grant-Gan/ECM_XLR_microphone/3D_Models/咪头支架_30mm.stl

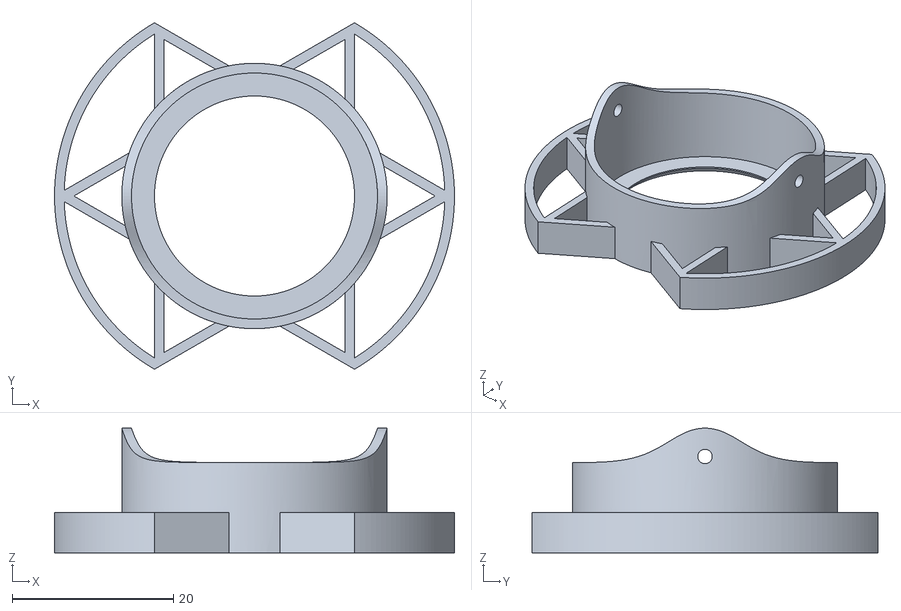
[picture p2: CAD file, 2025-09-05]
3D_Models/咪头支架_30mm.stl
49.6 x 43.0 x 15.5
