grant-Gan/ECM_XLR_microphone/3D_Models/下盖.stl

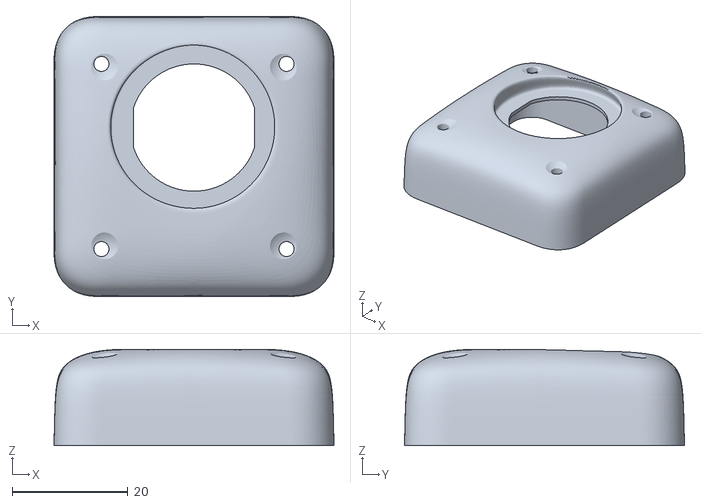
[picture p3: CAD file, 2025-09-05]
3D_Models/下盖.stl
48.4 x 48.4 x 16.6
