grant-Gan/ECM_XLR_microphone/3D_Models/咪头外壳.stl

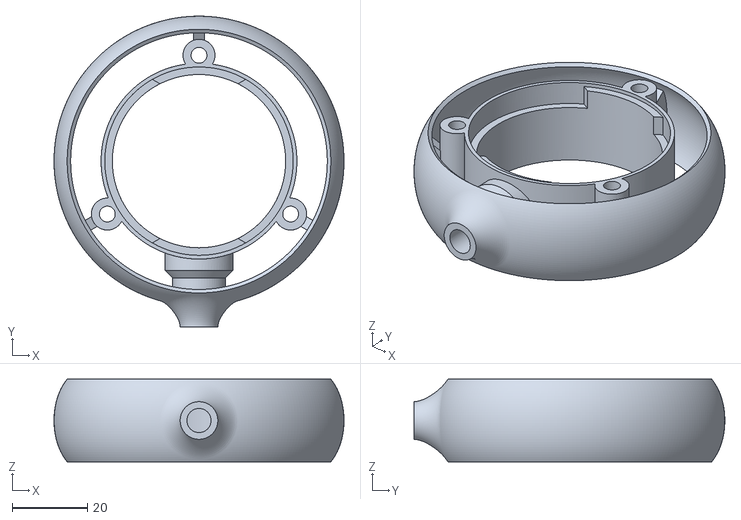
[picture p4: CAD file, 2025-09-05]
3D_Models/咪头外壳.stl
77.0 x 82.5 x 22.0
