grant-Gan/ECM_XLR_microphone/3D_Models/上盖.stl

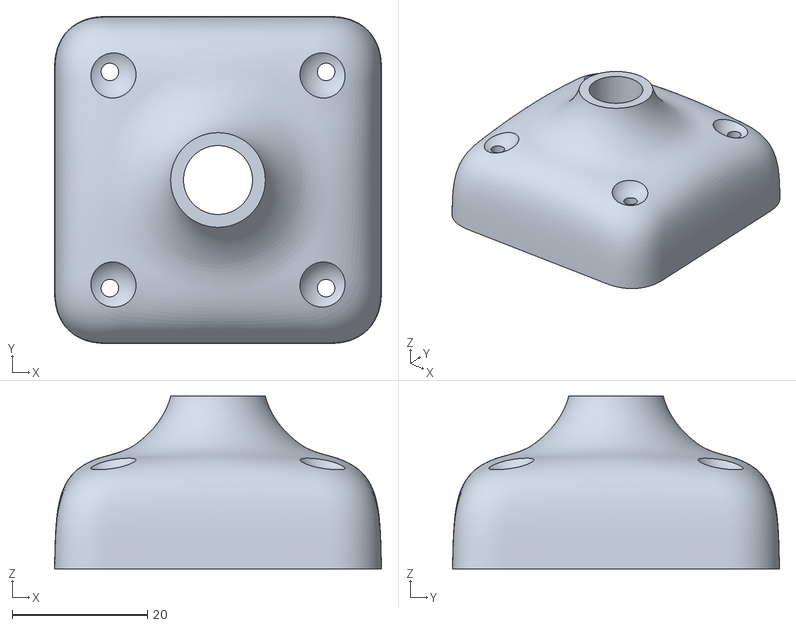
[picture p5: CAD file, 2025-09-05]
3D_Models/上盖.stl
48.4 x 48.4 x 25.6
