grant-Gan/ECM_XLR_microphone/PCB/Schematics/OPA_Alice_ECM_Microphone.pdf

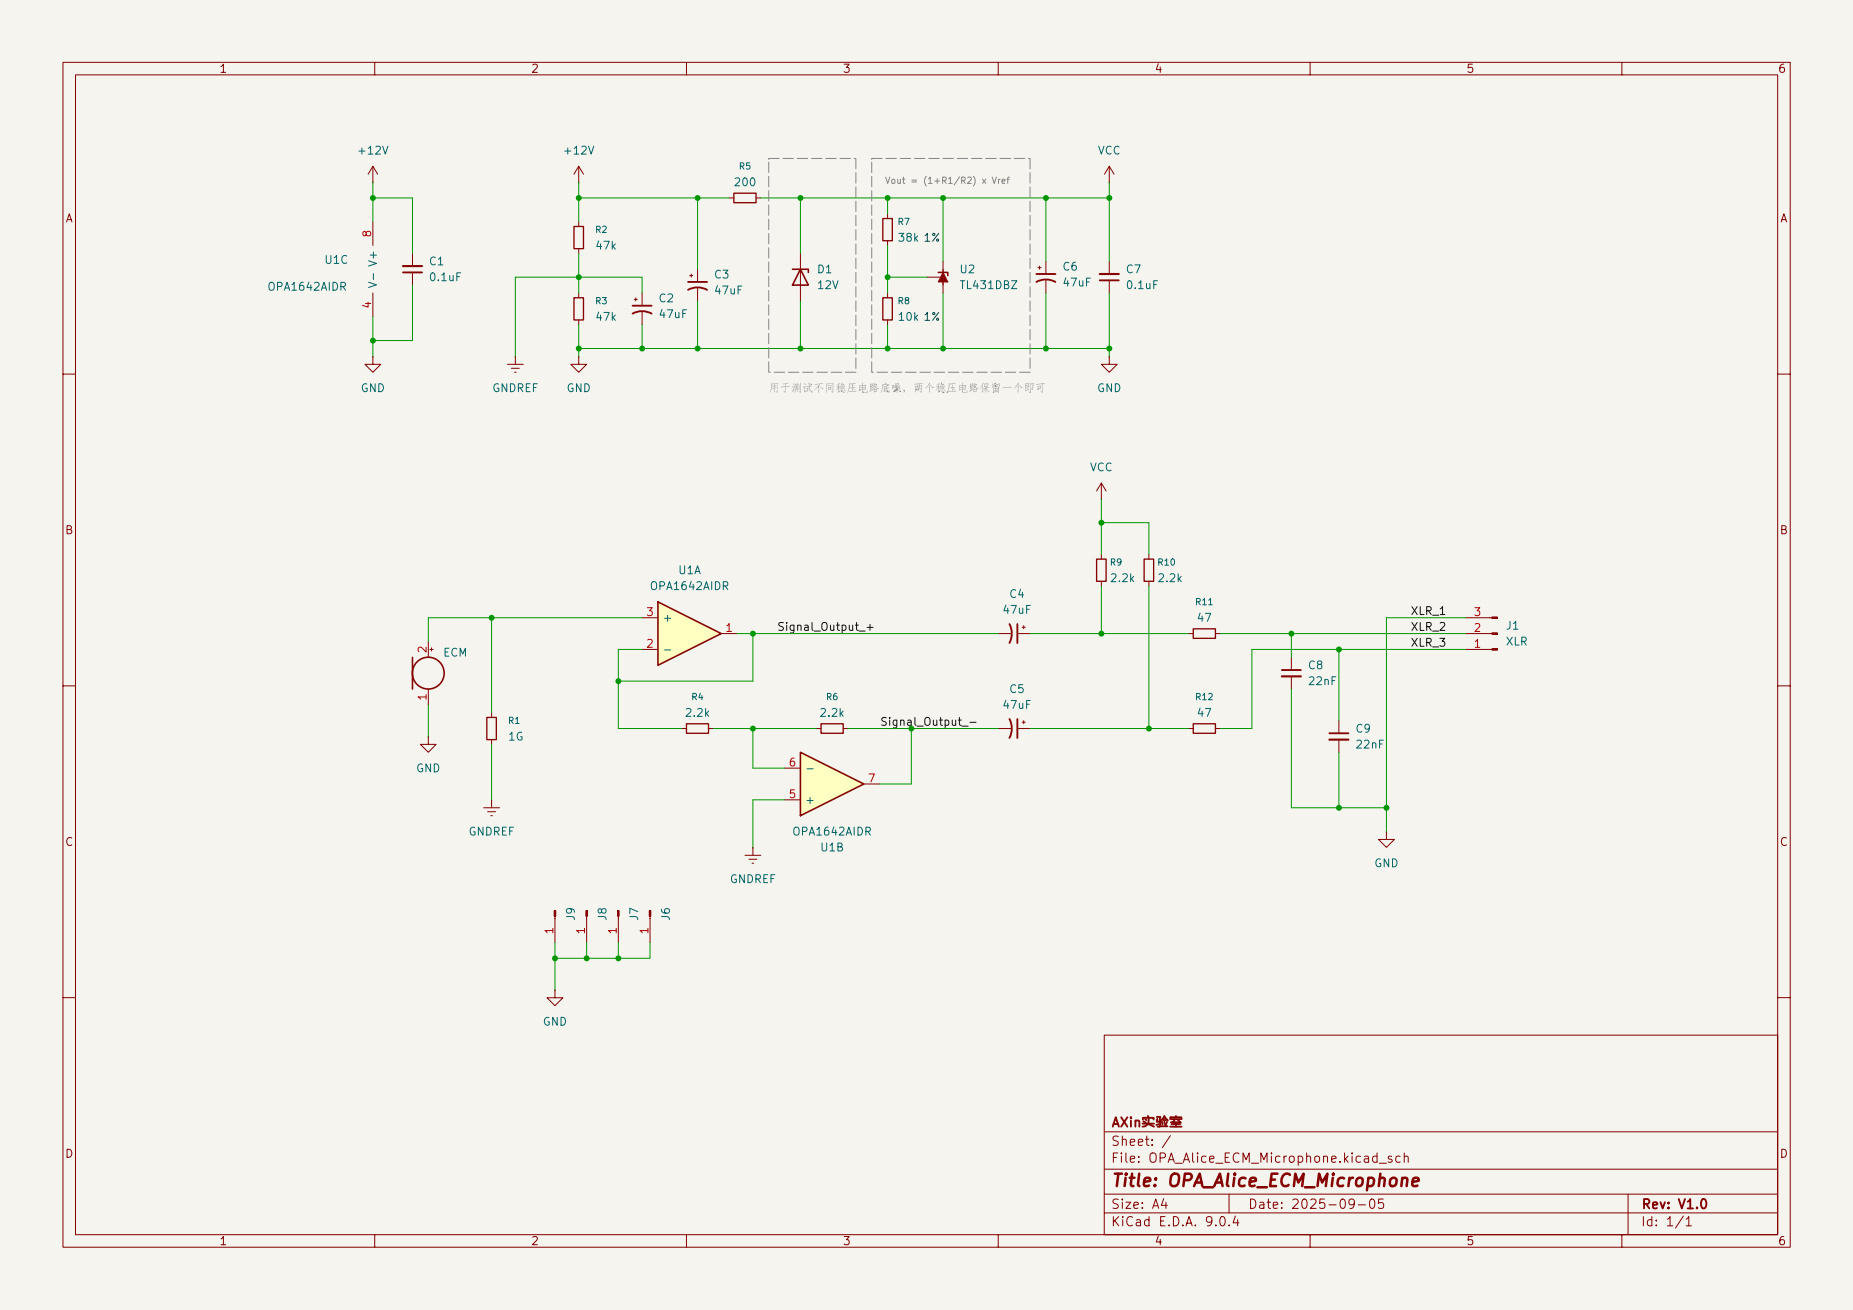
[picture p6: page 1]
