grant-Gan/ECM_XLR_microphone/PCB/PCB/OPA_Alice_ECM_Microphone_PCB.pdf

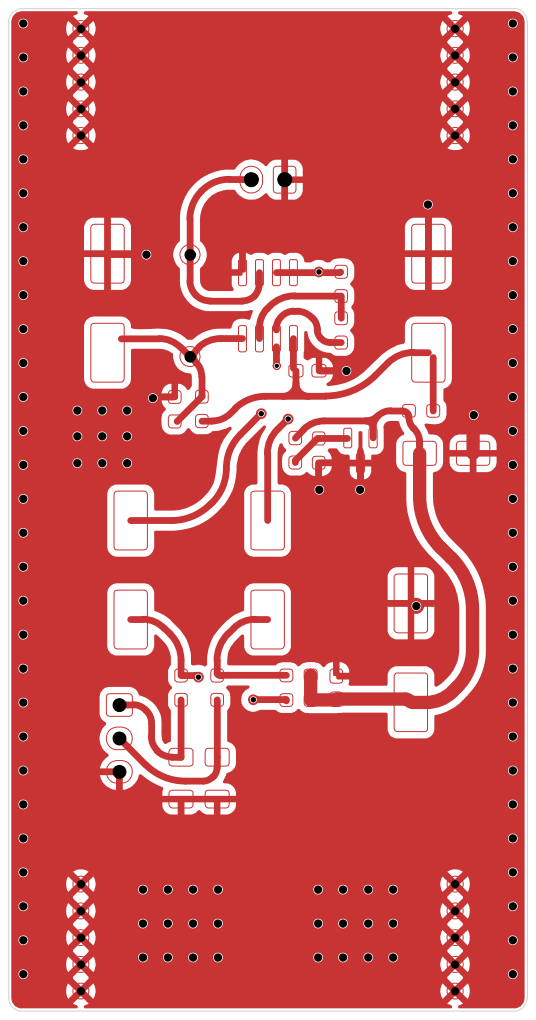
[picture p7: page 1]

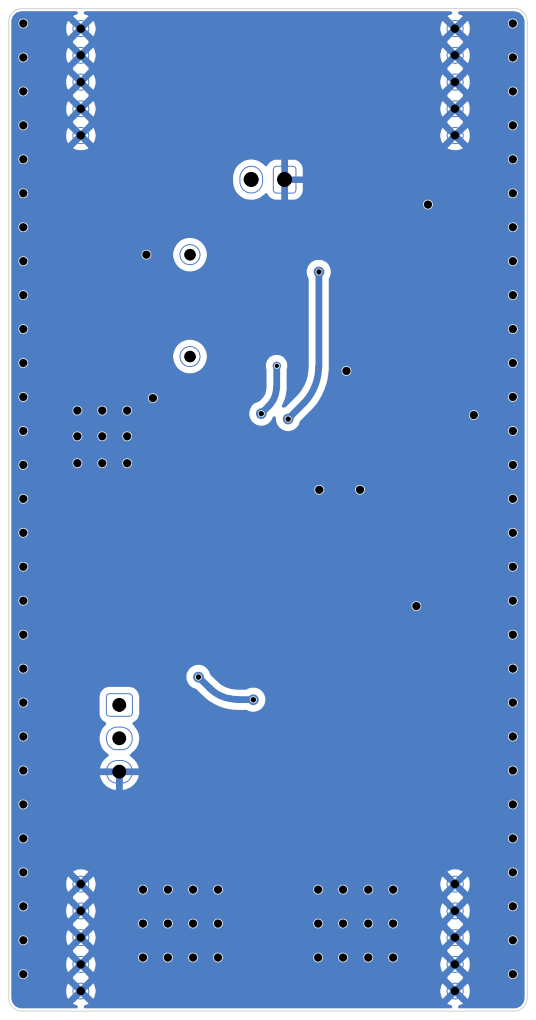
[picture p8: page 2]

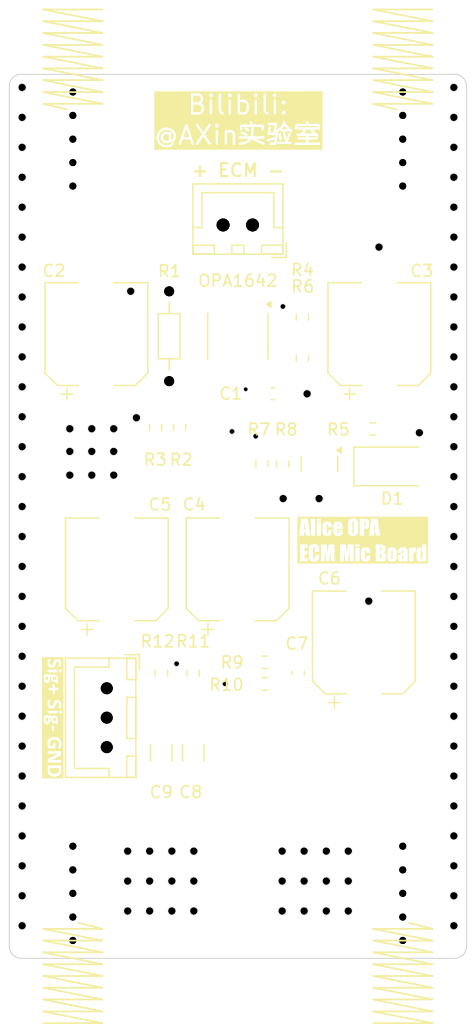
[picture p9: page 3]

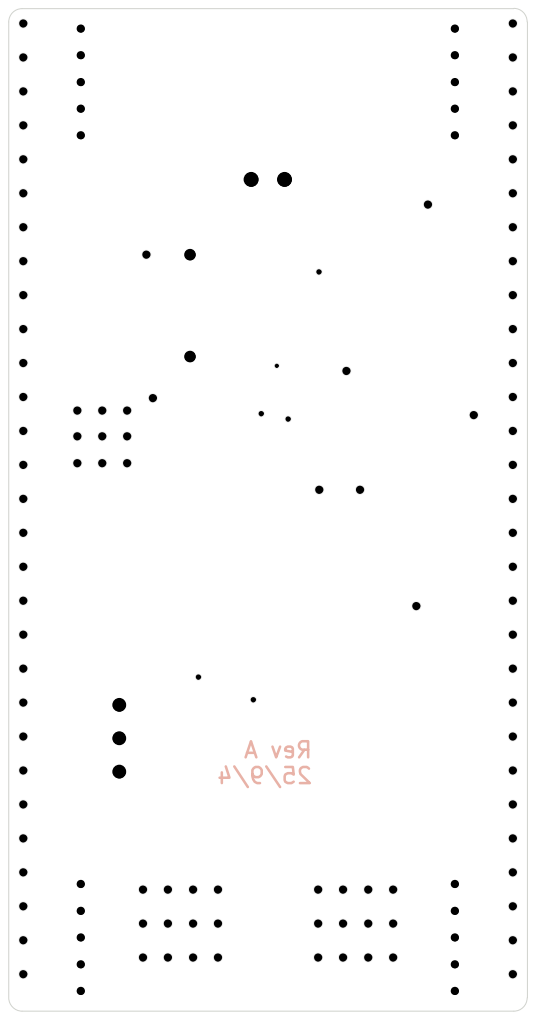
[picture p10: page 4]
