grant-Gan/ECM_XLR_microphone/PCB/Kicad_project/Alice_OPA_ECM_Microphone.kicad_pcb

## KiCad design PCB/Kicad_project/Alice_OPA_ECM_Microphone.kicad_pcb (2025-09-05)

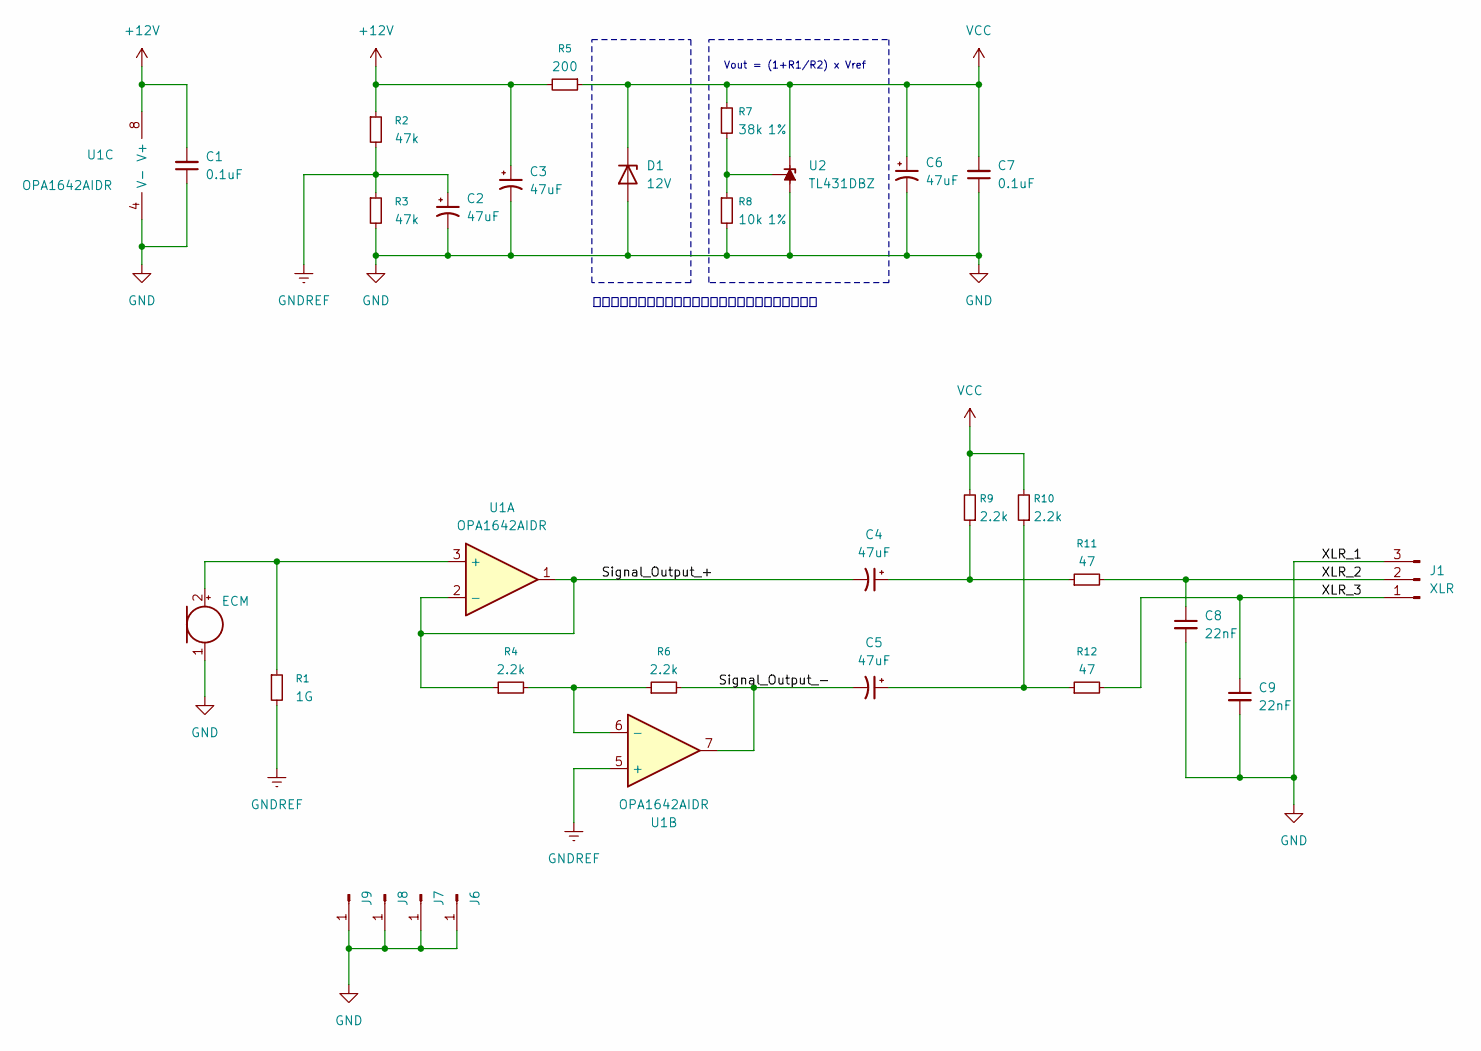
[picture p11: schematic Alice_OPA_ECM_Microphone.kicad_sch, OPA_Alice_ECM_Microphone]

Parts:
C1, C7: 0.1uF; C_0603_1608Metric_Pad1.08x0.95mm_HandSolder
C2, C3, C4, C5, C6: 47uF; CP_Elec_8x10.5; Voltage 63V
C8, C9: 22nF; C_1206_3216Metric_Pad1.33x1.80mm_HandSolder
D1: 12V; D_SMA
J1: XLR; JST_XH_B3B-XH-A_1x03_P2.50mm_Vertical
J6, J7, J8, J9: Conn_01x01_Pin; F5-9-0.4直筒内绕平行针_触摸弹簧
MK1: ECM; JST_XH_B2B-XH-A_1x02_P2.50mm_Vertical
R1: 1G; R_Axial_DIN0204_L3.6mm_D1.6mm_P7.62mm_Horizontal
R2, R3: 47k; R_0603_1608Metric_Pad0.98x0.95mm_HandSolder
R4, R6, R9, R10: 2.2k; R_0603_1608Metric_Pad0.98x0.95mm_HandSolder
R5: 200; R_0603_1608Metric_Pad0.98x0.95mm_HandSolder
R7: 38k; R_0603_1608Metric_Pad0.98x0.95mm_HandSolder
R8: 10k; R_0603_1608Metric_Pad0.98x0.95mm_HandSolder
R11, R12: 47; R_0603_1608Metric_Pad0.98x0.95mm_HandSolder
U1: OPA1642AIDR; SOIC-8_3.9x4.9mm_P1.27mm
U2: TL431DBZ; SOT-23

Connections:
+12V: C1.2, C3.1, R2.1, R5.2, U1.8 (V+)
/Signal_Output_+: C4.2, R4.1, U1.1, U1.2 (-)
/Signal_Output_-: C5.2, R6.2, U1.7
/XLR_2: C8.1, J1.2, R11.2
/XLR_3: C9.1, J1.1, R12.2
GND: C1.1, C2.2, C3.2, C6.2, C7.1, C8.2, C9.2, D1.2 (A), J1.3, J6.1, J7.1, J8.1, J9.1, MK1.1 (-), R3.2, R8.2, U1.4 (V-), U2.3 (A)
GNDREF: C2.1, R1.2, R2.2, R3.1, U1.5 (+)
unnamed: C4.1, R9.1, R11.1
unnamed: C5.1, R10.1, R12.1
unnamed: MK1.2 (+), R1.1, U1.3 (+)
unnamed: R4.2, R6.1, U1.6 (-)
unnamed: R7.2, R8.1, U2.2 (REF)
VCC: C6.1, C7.2, D1.1 (K), R5.1, R7.1, R9.2, R10.2, U2.1 (K)

Notes on the sheet:
Vout = (1+R1/R2) x Vref
用于测试不同稳压电路底噪，两个稳压电路保留一个即可

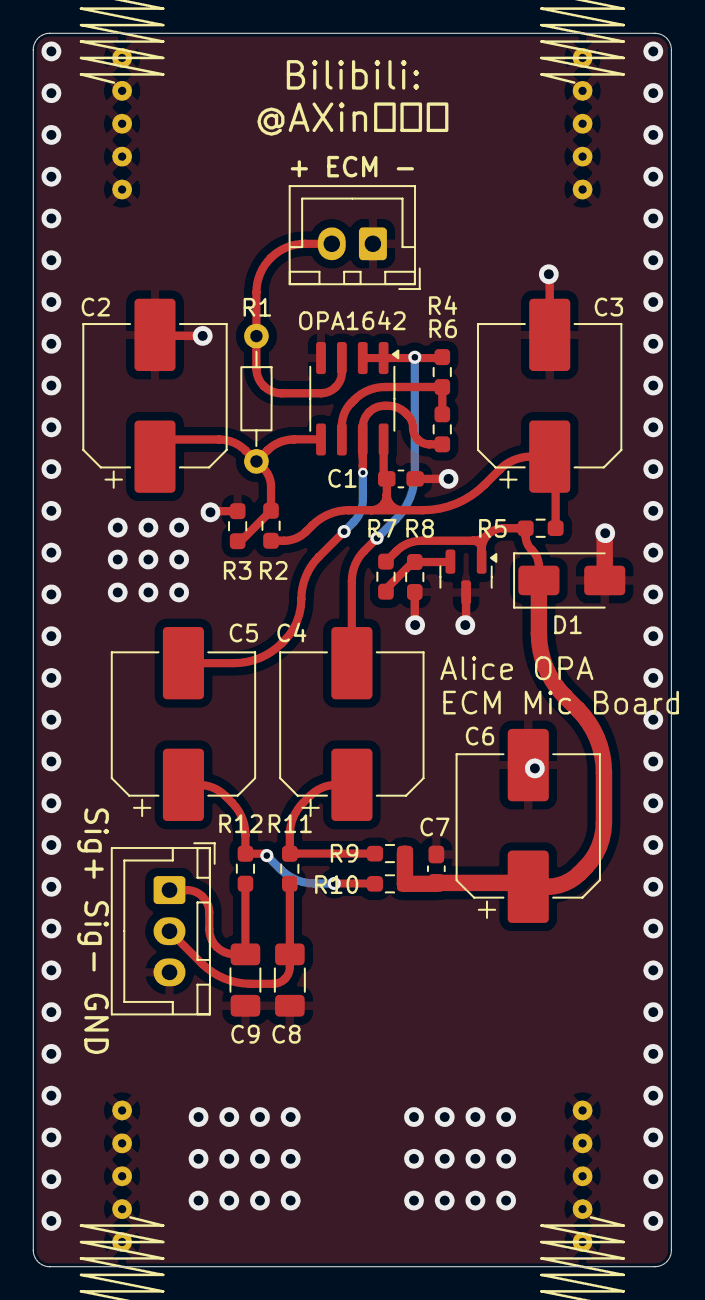
[picture p12: board Alice_OPA_ECM_Microphone.kicad_pcb from above]

Board: 2 copper layers, 38.8 x 75.0 mm, 30 parts (0 on the bottom side), 13 nets.
