grant-Gan/ECM_XLR_microphone/(notices)

Notices in the files:
README.md:
MIT License
